cidrenthesecond/UWU_AK/Hardware/UWU_AK_V2/LIB_LM4889MA_NOPB/LM4889MA_NOPB/3D/LM4889MA_NOPB.stp

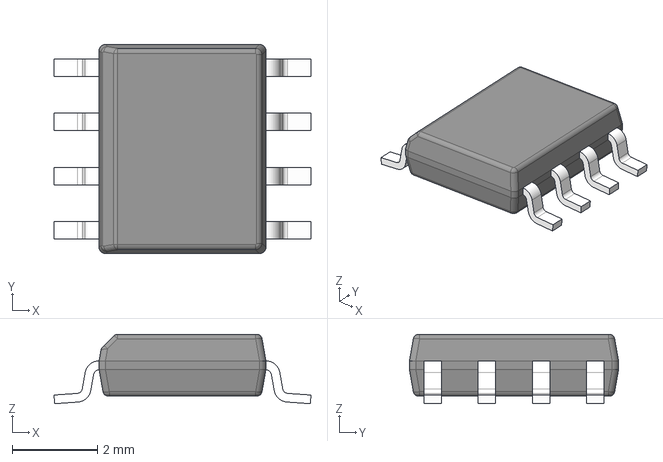
[picture p1: CAD file, 2026-02-10]
Hardware/UWU_AK_V2/LIB_LM4889MA_NOPB/LM4889MA_NOPB/3D/LM4889MA_NOPB.stp
6.02 x 4.90 x 1.63 mm
BODY-SO
LEAD-D0008A x 8
