cidrenthesecond/UWU_AK/(list of files, cad)

Other CAD files:
Hardware/UWU_AK_V2/LIB_LM4889MA_NOPB/LM4889MA_NOPB/Allegro/soic127p600x175-8n.psm
Hardware/UWU_AK_V2/LIB_LM4889MA_NOPB/LM4889MA_NOPB/DEHDL/lm4889ma_nopb/chips/chips.prt
Hardware/UWU_AK_V3_Mouse/LIB_LM4889MA_NOPB/LM4889MA_NOPB/Allegro/soic127p600x175-8n.psm
Hardware/UWU_AK_V3_Mouse/LIB_LM4889MA_NOPB/LM4889MA_NOPB/DEHDL/lm4889ma_nopb/chips/chips.prt
