cidrenthesecond/UWU_AK/(list of files, drawings)

Other design files:
Hardware/UWU_AK_V2/LIB_LM4889MA_NOPB/LM4889MA_NOPB/Altium/LM4889MA_NOPB.SchLib
Hardware/UWU_AK_V2/LIB_LM4889MA_NOPB/LM4889MA_NOPB/Altium/SOIC127P600X175-8N.PcbLib
Hardware/UWU_AK_V3_Mouse/LIB_LM4889MA_NOPB/LM4889MA_NOPB/Altium/LM4889MA_NOPB.SchLib
Hardware/UWU_AK_V3_Mouse/LIB_LM4889MA_NOPB/LM4889MA_NOPB/Altium/SOIC127P600X175-8N.PcbLib
