cidrenthesecond/UWU_AK/Hardware/UWU_AK_V2/UWU_AK_V2.kicad_pcb

## KiCad design Hardware/UWU_AK_V2/UWU_AK_V2.kicad_pcb (2026-02-10)

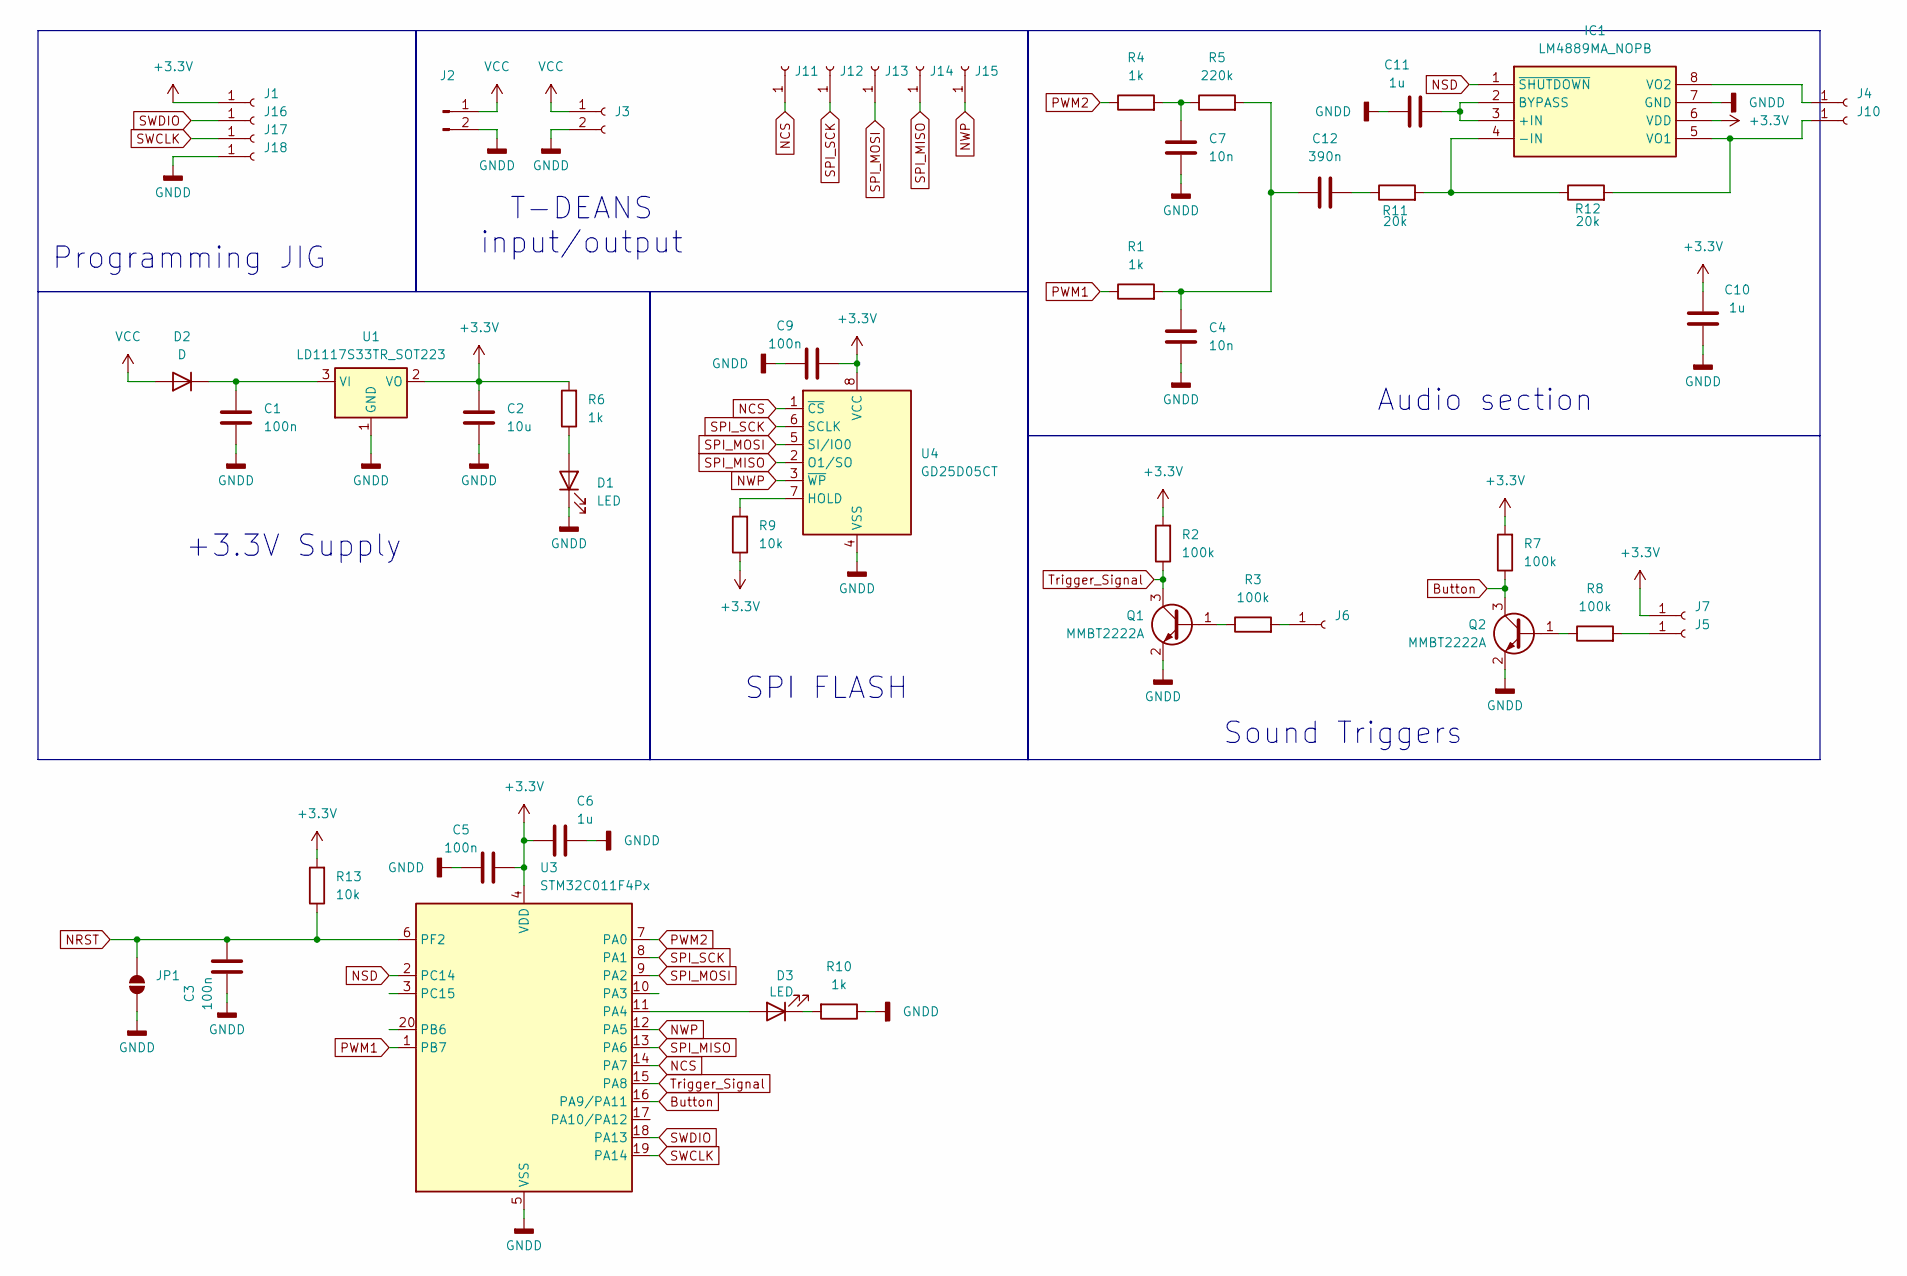
[picture p2: schematic UWU_AK_V2.kicad_sch]

Parts:
C1, C3, C5, C9: 100n; C_0805_2012Metric_Pad1.18x1.45mm_HandSolder
C2: 10u; C_0805_2012Metric_Pad1.18x1.45mm_HandSolder
C4, C7: 10n; C_0805_2012Metric_Pad1.18x1.45mm_HandSolder
C6, C10, C11: 1u; C_0805_2012Metric_Pad1.18x1.45mm_HandSolder
C12: 390n; C_0805_2012Metric_Pad1.18x1.45mm_HandSolder
D1, D3: LED; LED_0805_2012Metric_Pad1.15x1.40mm_HandSolder
D2: D; D_SMA
IC1: LM4889MA_NOPB; SOIC127P600X175-8N; Manufacturer_Part_Number LM4889MA/NOPB
J1, J4, J5, J6, J7, J10, J18: Conn_01x01_Socket; SolderWirePad_1x01_SMD_2x4mm
J2: Conn_01x02_Pin; T_DEANS_MALE_1
J3: Conn_01x02_Socket; T_DEANS_FEMALE_2
J11, J12, J13, J14, J15, J16, J17: Conn_01x01_Socket; SolderWirePad_1x01_SMD_1x2mm
JP1: SolderJumper_2_Open; SolderJumper-2_P1.3mm_Open_TrianglePad1.0x1.5mm
Q1, Q2: MMBT2222A; SOT-23
R1, R4, R6, R10: 1k; R_0805_2012Metric_Pad1.20x1.40mm_HandSolder
R2, R3, R7, R8: 100k; R_0805_2012Metric_Pad1.20x1.40mm_HandSolder
R5: 220k; R_0805_2012Metric_Pad1.20x1.40mm_HandSolder
R9, R13: 10k; R_0805_2012Metric_Pad1.20x1.40mm_HandSolder
R11, R12: 20k; R_0805_2012Metric_Pad1.20x1.40mm_HandSolder
U1: LD1117S33TR_SOT223; SOT-223-3_TabPin2
U3: STM32C011F4Px; TSSOP-20_4.4x6.5mm_P0.65mm
U4: GD25D05CT; JEITA_SOIC-8_3.9x4.9mm_P1.27mm

Connections:
+3.3V: C2.1, C5.2, C6.1, C9.2, C10.2, IC1.6 (VDD), J1.1, J7.1, R2.2, R6.2, R7.2, R9.1, R13.2, U1.2 (VO), U3.4 (VDD), U4.8 (VCC)
Button: Q2.3 (C), R7.1, U3.16 (PA9/PA11)
GNDD: C1.2, C2.2, C3.1, C4.2, C5.1, C6.2, C7.2, C9.1, C10.1, C11.1, D1.1 (K), IC1.7 (GND), J2.2, J3.2, J18.1, JP1.1 (A), Q1.2 (E), Q2.2 (E), R10.1, U1.1 (GND), U3.5 (VSS), U4.4 (VSS)
NCS: J11.1, U3.14 (PA7), U4.1 (~CS)
NRST: C3.2, JP1.2 (B), R13.1, U3.6 (PF2)
NSD: IC1.1 (~SHUTDOWN), U3.2 (PC14)
NWP: J15.1, U3.12 (PA5), U4.3 (~WP)
unnamed: C7.1, R4.2, R5.1
unnamed: C4.1, C12.1, R1.2, R5.2
unnamed: C12.2, R11.1
unnamed: D1.2 (A), R6.1
unnamed: C1.1, D2.1 (K), U1.3 (VI)
unnamed: D3.2 (A), U3.11 (PA4)
unnamed: D3.1 (K), R10.2
unnamed: C11.2, IC1.2 (BYPASS), IC1.3 (+IN)
unnamed: IC1.4 (-IN), R11.2, R12.1
unnamed: IC1.5 (VO1), J10.1, R12.2
unnamed: IC1.8 (VO2), J4.1
unnamed: J5.1, R8.2
unnamed: J6.1, R3.2
unnamed: Q1.1 (B), R3.1
unnamed: Q2.1 (B), R8.1
unnamed: R9.2, U4.7 (HOLD)
PWM1: R1.1, U3.1 (PB7)
PWM2: R4.1, U3.7 (PA0)
SPI_MISO: J14.1, U3.13 (PA6), U4.2 (O1/SO)
SPI_MOSI: J13.1, U3.9 (PA2), U4.5 (SI/IO0)
SPI_SCK: J12.1, U3.8 (PA1), U4.6 (SCLK)
SWCLK: J17.1, U3.19 (PA14)
SWDIO: J16.1, U3.18 (PA13)
Trigger_Signal: Q1.3 (C), R2.1, U3.15 (PA8)
VCC: D2.2 (A), J2.1, J3.1

Notes on the sheet:
SPI FLASH
Programming JIG
Audio section
+3.3V Supply
Sound Triggers
T-DEANS input/output

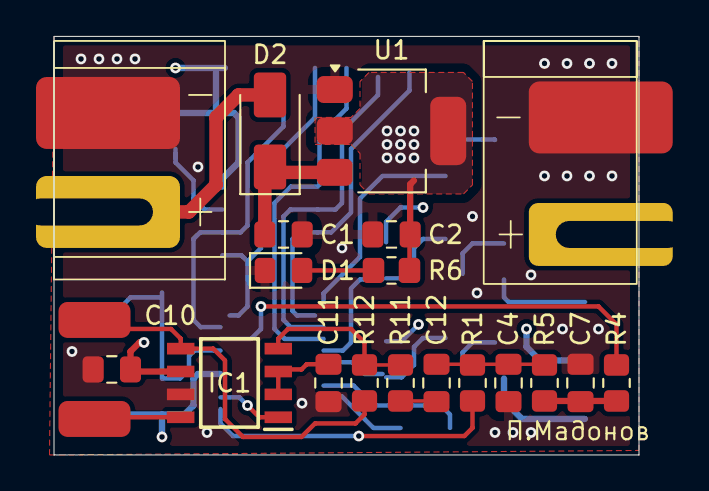
[picture p3: board UWU_AK_V2.kicad_pcb from above]

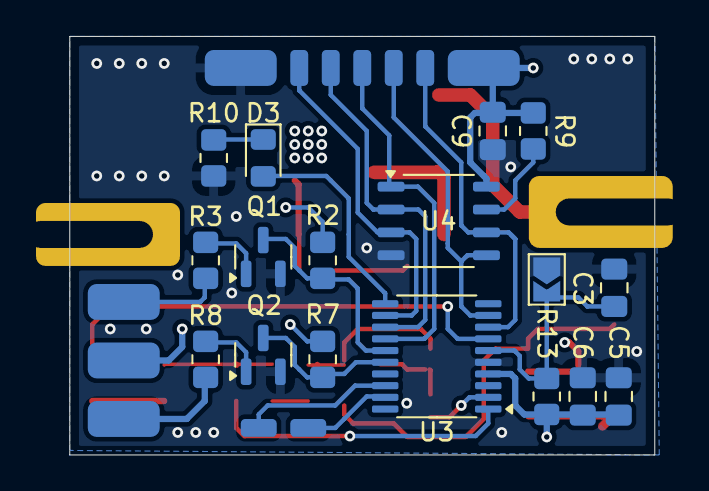
[picture p4: board UWU_AK_V2.kicad_pcb from below]

Board: 4 copper layers, 32.5 x 23.2 mm, 50 parts (29 on the bottom side), 32 nets.
