cidrenthesecond/UWU_AK/Firmware/Core/Src/main.c

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
/* Includes ------------------------------------------------------------------*/
#include "main.h"
#include "spi.h"
#include "tim.h"
#include "gpio.h"

/* USER CODE BEGIN Includes */
#include "system.h"
/* USER CODE END Includes */


void SystemClock_Config(void);
/**
  * @brief  The application entry point.
  * @retval int
  */
int main(void)
{

  /* MCU Configuration--------------------------------------------------------*/

  /* Reset of all peripherals, Initializes the Flash interface and the Systick. */
  LL_APB2_GRP1_EnableClock(LL_APB2_GRP1_PERIPH_SYSCFG);
  LL_APB1_GRP1_EnableClock(LL_APB1_GRP1_PERIPH_PWR);

  /* SysTick_IRQn interrupt configuration */
  NVIC_SetPriority(SysTick_IRQn, 3);

  /* Configure the system clock */
  SystemClock_Config();

  /* Initialize all configured peripherals */
  MX_GPIO_Init();
  MX_SPI1_Init();
  MX_TIM1_Init();
  /* Infinite loop */
  /* USER CODE BEGIN WHILE */

  SystemBoot();

  /*---------------LEFT HERE FOR FUTURE ME------------------------
  //LL_TIM_EnableCounter(TIM1);
  //LL_TIM_OC_SetMode(TIM1, LL_TIM_CHANNEL_CH4, LL_TIM_OCMODE_PWM1);
  ----------------------------------------------------------------*/

  while (1)
  {
	NewMain();

    /* USER CODE END WHILE */

    /* USER CODE BEGIN 3 */

  }
  /* USER CODE END 3 */
}

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
