cidrenthesecond/UWU_AK/Firmware/Core/Inc/main.h

#define PWM1_Pin LL_GPIO_PIN_7
#define PWM1_GPIO_Port GPIOB
#define NSD_Pin LL_GPIO_PIN_14
#define NSD_GPIO_Port GPIOC
#define LED_Pin LL_GPIO_PIN_4
#define LED_GPIO_Port GPIOA
#define NWP_Pin LL_GPIO_PIN_5
#define NWP_GPIO_Port GPIOA
#define NCS_Pin LL_GPIO_PIN_7
#define NCS_GPIO_Port GPIOA
#define Trigger_Pin LL_GPIO_PIN_8
#define Trigger_GPIO_Port GPIOA
#define Trigger_EXTI_IRQn EXTI4_15_IRQn
#define Button_Pin LL_GPIO_PIN_11
#define Button_GPIO_Port GPIOA
#define Button_EXTI_IRQn EXTI4_15_IRQn
#define NVIC_PRIORITYGROUP_0         ((uint32_t)0x00000007) /*!< 0 bit  for pre-emption priority,
#define NVIC_PRIORITYGROUP_1         ((uint32_t)0x00000006) /*!< 1 bit  for pre-emption priority,
#define NVIC_PRIORITYGROUP_2         ((uint32_t)0x00000005) /*!< 2 bits for pre-emption priority,
#define NVIC_PRIORITYGROUP_3         ((uint32_t)0x00000004) /*!< 3 bits for pre-emption priority,
#define NVIC_PRIORITYGROUP_4         ((uint32_t)0x00000003) /*!< 4 bits for pre-emption priority,
