cidrenthesecond/UWU_AK/(commit log)

2026-01-16 systems works, click bugs out, cracks
    [doublebuffer.c, doublebuffer.h, main.c, spi_project.c, spi_project.h, system.c, system.h]
2026-01-16 Click fixed, still cracks
    [spi_project.c, system.c]
2026-01-30 cracks are barely audible, minor fixes
    [doublebuffer.c, doublebuffer.h, main.c, spi_project.c, system.c, system.h]
2026-02-10 Addition of hardware files
    [EDI2CAP.CFG, LM4889MA_NOPB.SchLib, LM4889MA_NOPB.stp, SOIC127P600X175-8N.PcbLib, UWU_AK_V2.kicad_pcb, UWU_AK_V2.kicad_sch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]
